MaxMaeder/SandTimer/casings/rev2/casings/Top.stl

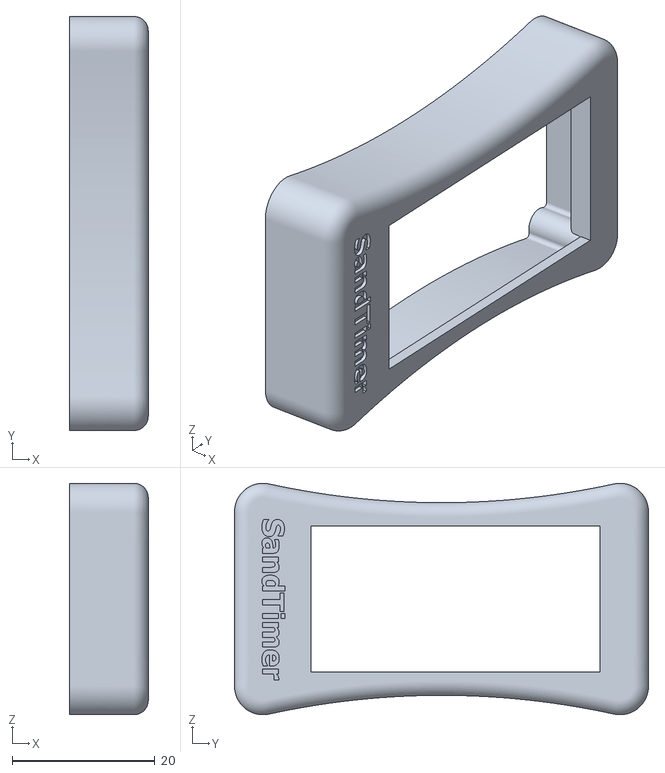
[picture p1: CAD file, 2024-05-12]
casings/rev2/casings/Top.stl
11.0 x 58.0 x 32.4
