MaxMaeder/SandTimer/casings/rev2/casings/Bottom.stl

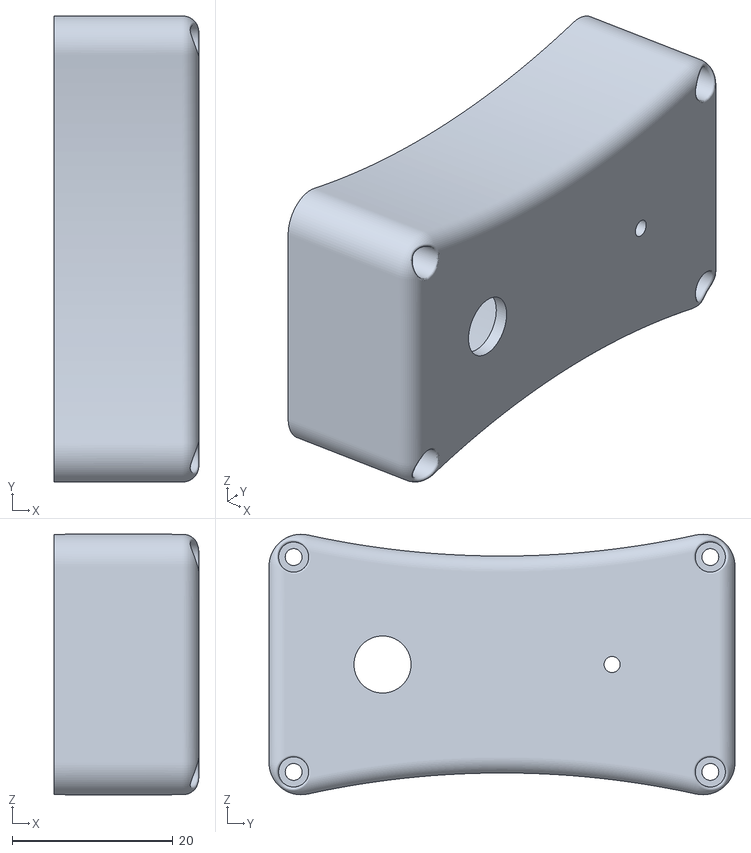
[picture p2: CAD file, 2024-05-12]
casings/rev2/casings/Bottom.stl
18.0 x 58.0 x 32.4
