MaxMaeder/SandTimer/casings/rev1/casings/FrontCasing.stl

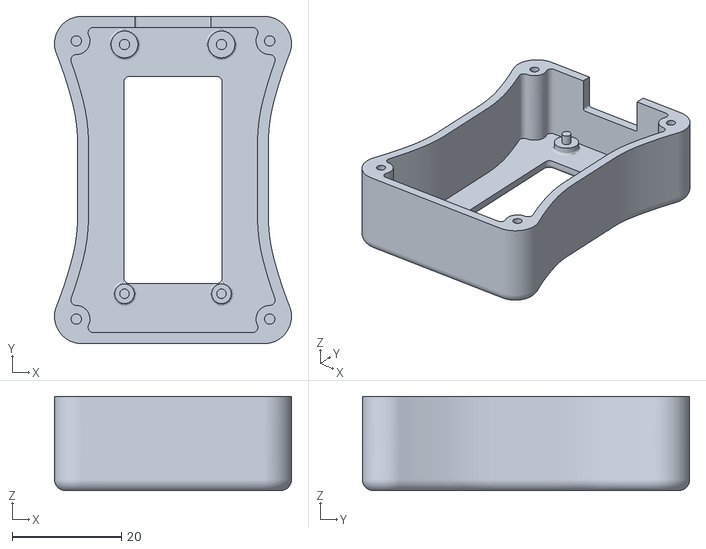
[picture p3: CAD file, 2024-05-12, an earlier design]
casings/rev1/casings/FrontCasing.stl
43.5 x 60.0 x 17.2
