MaxMaeder/SandTimer/casings/rev1/casings/BackCasing.stl

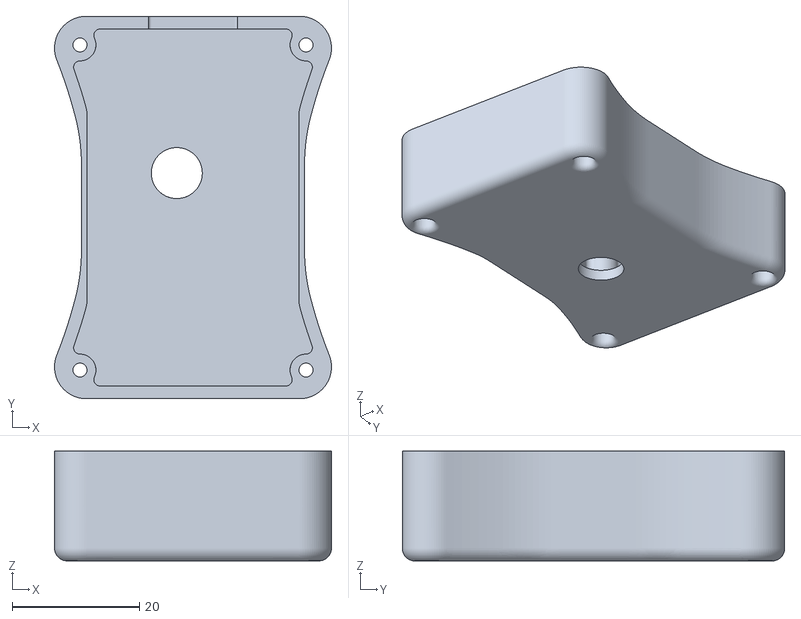
[picture p4: CAD file, 2024-05-12, an earlier design]
casings/rev1/casings/BackCasing.stl
43.5 x 60.0 x 17.2
