MaxMaeder/SandTimer/(list of files, cad)

Other CAD files:
casings/rev1/casings/BackCasing.ipt
casings/rev1/casings/Electronic Assembly.ipt
casings/rev1/casings/FrontCasing.ipt
casings/rev1/casings/OldVersions/BackCasing.0010.ipt
casings/rev1/casings/OldVersions/Electronic Assembly.0008.ipt
casings/rev1/casings/OldVersions/FrontCasing.0009.ipt
casings/rev1/casings/OldVersions/SandTimer.0003.iam
casings/rev1/casings/OldVersions/Stepper.0001.ipt
casings/rev1/casings/SandTimer.iam
casings/rev2/casings/12-Pin Header.ipt
casings/rev2/casings/16-Pin Header.ipt
casings/rev2/casings/Battery.ipt
casings/rev2/casings/Bottom.ipt
casings/rev2/casings/Controller Board.ipt
casings/rev2/casings/LED Board.ipt
casings/rev2/casings/OldVersions/12-Pin Header.0005.ipt
casings/rev2/casings/OldVersions/16-Pin Header.0004.ipt
casings/rev2/casings/OldVersions/Bottom.0027.ipt
casings/rev2/casings/OldVersions/Controller Board.0008.ipt
casings/rev2/casings/OldVersions/Controller Board.0009.ipt
casings/rev2/casings/OldVersions/LED Board.0007.ipt
casings/rev2/casings/OldVersions/Sand Timer.0019.iam
casings/rev2/casings/OldVersions/Top.0035.ipt
casings/rev2/casings/OldVersions/USB C Plug.0002.ipt
casings/rev2/casings/Sand Timer.iam
casings/rev2/casings/Top.ipt
casings/rev2/casings/USB C Plug.ipt
casings/rev2/casings/v1 - Bottom.ipt
casings/rev2/casings/v1 - Top.ipt
casings/rev2/casings/v1.1 - Bottom.ipt
casings/rev2/casings/v1.1 - Top.ipt
