MaxMaeder/SandTimer/boards/TimerControl.brd

## EAGLE design boards/TimerControl.brd (2024-01-23)

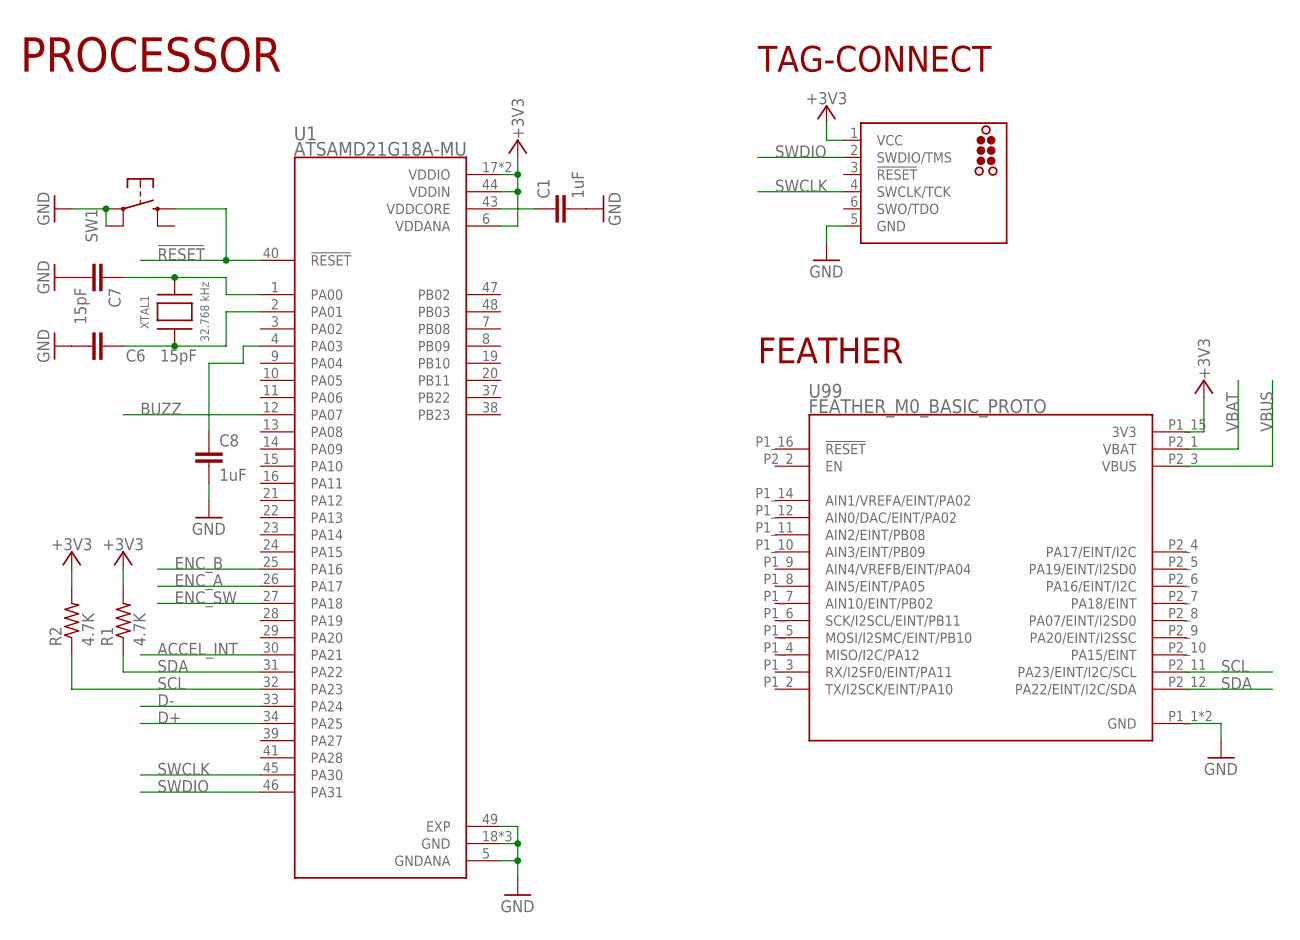
[picture p5: schematic TimerControl.sch, sheet 1]

Parts:
C1, C8: 1uF; C0603
C6, C7: 15pF; C0603
J3: TC2030_SWD-MCP-NL; TC2030-MCP-NL
R1, R2: 4.7K; R0603
SW1: KMR2; 2.80X4.60
U1: ATSAMD21G18A-MU; QFN50P700X700X90-49N
U99: FEATHER_M0_BASIC_PROTO; MODULE_FEATHER_M0_BASIC_PROTO
XTAL1: 32.768 kHz; XTAL3215

Connections:
!RESET: SW1.B (S), U1.40 (!RESET)
+3V3: J3.1 (VCC), R1.2, R2.2, U1.6 (VDDANA), U1.17 (VDDIO), U1.36 (VDDIO), U1.44 (VDDIN), U99.P1_15 (3V3); also elsewhere on the board
ACCEL_INT: U1.30 (PA21); also elsewhere on the board
BUZZ: U1.12 (PA07); also elsewhere on the board
D+: U1.34 (PA25); also elsewhere on the board
D-: U1.33 (PA24); also elsewhere on the board
ENC_A: U1.26 (PA17); also elsewhere on the board
ENC_B: U1.25 (PA16); also elsewhere on the board
ENC_SW: U1.27 (PA18); also elsewhere on the board
GND: C1.2, C6.2, C7.2, C8.2, J3.5 (GND), SW1.A, SW1.A' (P1), U1.5 (GNDANA), U1.18 (GND), U1.35 (GND), U1.42 (GND), U1.49 (EXP), U99.P1_1 (GND), U99.P1_13 (GND); also elsewhere on the board
unnamed: C1.1, U1.43 (VDDCORE)
unnamed: C8.1, U1.4 (PA03)
unnamed: C6.1, U1.2 (PA01), XTAL1.P$1
unnamed: C7.1, U1.1 (PA00), XTAL1.P$2
SCL: R2.1, U1.32 (PA23), U99.P2_11 (PA23/EINT/I2C/SCL); also elsewhere on the board
SDA: R1.1, U1.31 (PA22), U99.P2_12 (PA22/EINT/I2C/SDA); also elsewhere on the board
SWCLK: J3.4 (SWCLK/TCK), U1.45 (PA30)
SWDIO: J3.2 (SWDIO/TMS), U1.46 (PA31)
VBAT: U99.P2_1 (VBAT); also elsewhere on the board
VBUS: U99.P2_3 (VBUS); also elsewhere on the board

Notes on the sheet:
TAG-CONNECT
PROCESSOR
FEATHER

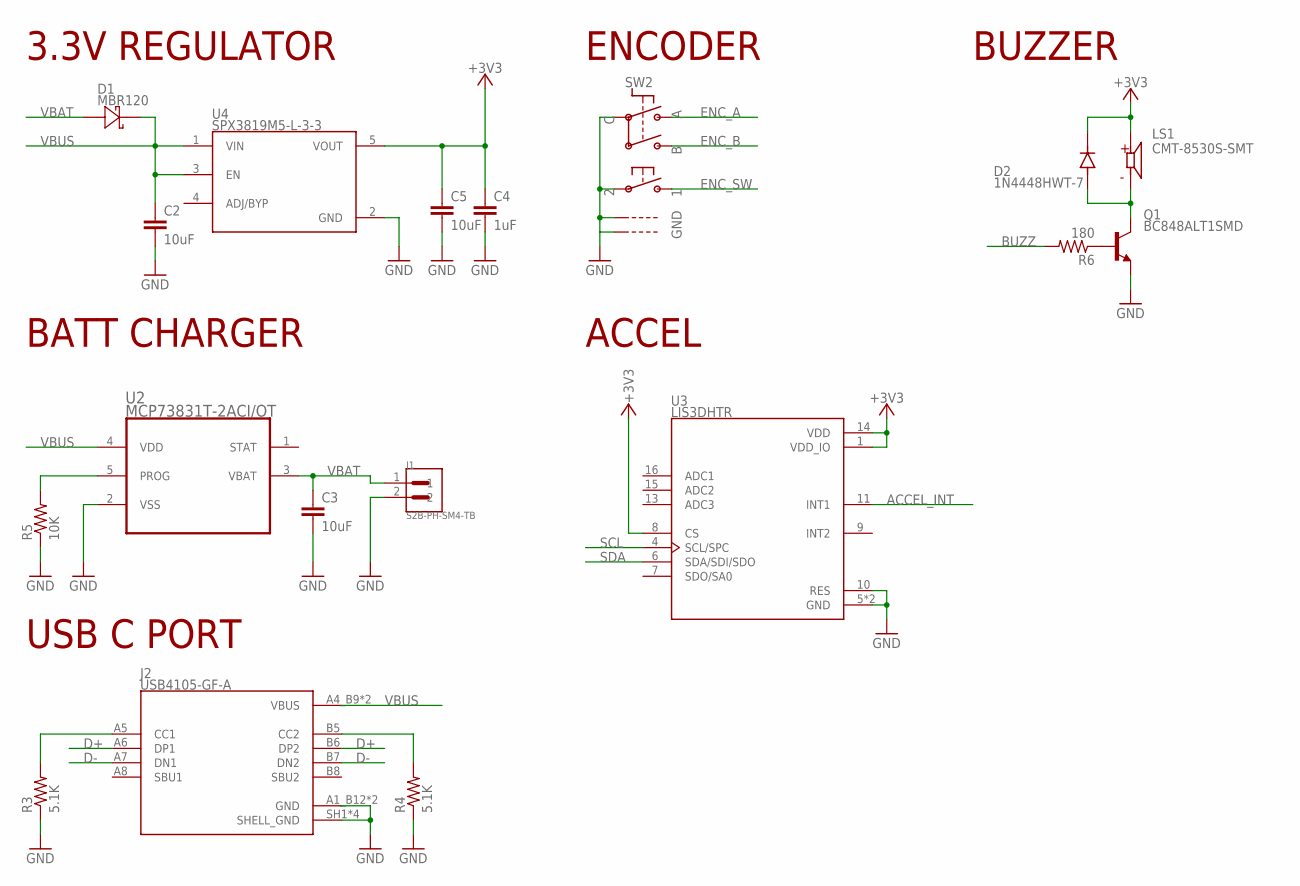
[picture p6: schematic TimerControl.sch, sheet 2]

Parts:
C2, C3, C5: 10uF; C0603
C4: 1uF; C0603
D1: MBR120; SOD−123FL
D2: 1N4448HWT-7; SODFL1608X65N
J1: S2B-PH-SM4-TB; JST_S2B-PH-SM4-TB
J2: USB4105-GF-A; GCT_USB4105-GF-A
LS1: CMT-8530S-SMT; CUI_CMT-8530S-SMT
Q1: BC848ALT1SMD; SOT23
R3, R4: 5.1K; R0603
R5: 10K; R0603
R6: 180; R0603
SW2: PEC11R_BOURNS_PEC11; PEC11R
U2: MCP73831T-2ACI/OT; SOT95P280X145-5N
U3: LIS3DHTR; XDCR_LIS3DHTR
U4: SPX3819M5-L-3-3; SOT95P280X145-5N

Connections:
+3V3: C4.1, C5.1, D2.C (K), LS1.P, U3.1 (VDD_IO), U3.8 (CS), U3.14 (VDD), U4.5 (VOUT); also elsewhere on the board
ACCEL_INT: U3.11 (INT1); also elsewhere on the board
BUZZ: R6.2; also elsewhere on the board
D+: J2.A6 (DP1), J2.B6 (DP2); also elsewhere on the board
D-: J2.A7 (DN1), J2.B7 (DN2); also elsewhere on the board
ENC_A: SW2.P$A; also elsewhere on the board
ENC_B: SW2.P$B; also elsewhere on the board
ENC_SW: SW2.P$1; also elsewhere on the board
GND: C2.2, C3.2, C4.2, C5.2, J1.2, J2.A1_B12 (GND), J2.B1_A12 (GND), J2.SH1 (SHELL_GND), J2.SH2 (SHELL_GND), J2.SH3 (SHELL_GND), J2.SH4 (SHELL_GND), Q1.2 (E), R3.1, R4.1, R5.1, SW2.P$2, SW2.P$C, SW2.P$GND1, SW2.P$GND2, U2.2 (VSS), U3.5 (GND), U3.10 (RES), U3.12 (GND), U4.2 (GND); also elsewhere on the board
unnamed: R5.2, U2.5 (PROG)
unnamed: J2.B5 (CC2), R4.2
unnamed: D2.A, LS1.N, Q1.3 (C)
unnamed: Q1.1 (B), R6.1
unnamed: J2.A5 (CC1), R3.2
SCL: U3.4 (SCL/SPC); also elsewhere on the board
SDA: U3.6 (SDA/SDI/SDO); also elsewhere on the board
VBAT: C3.1, D1.A (2), J1.1, U2.3 (VBAT); also elsewhere on the board
VBUS: C2.1, D1.C (1), J2.A4_B9 (VBUS), J2.B4_A9 (VBUS), U2.4 (VDD), U4.1 (VIN), U4.3 (EN); also elsewhere on the board

Notes on the sheet:
3.3V REGULATOR
BATT CHARGER
USB C PORT
ENCODER
ACCEL
BUZZER

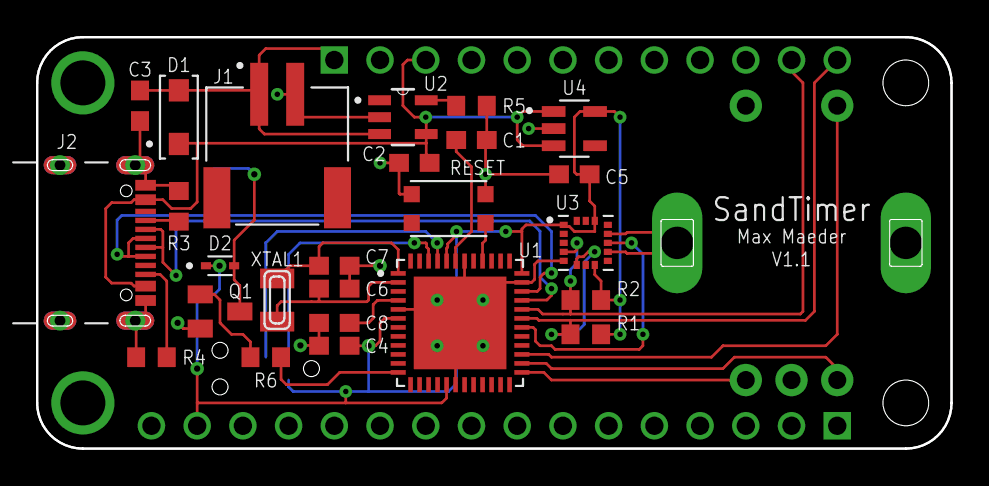
[picture p7: board TimerControl.brd from above]

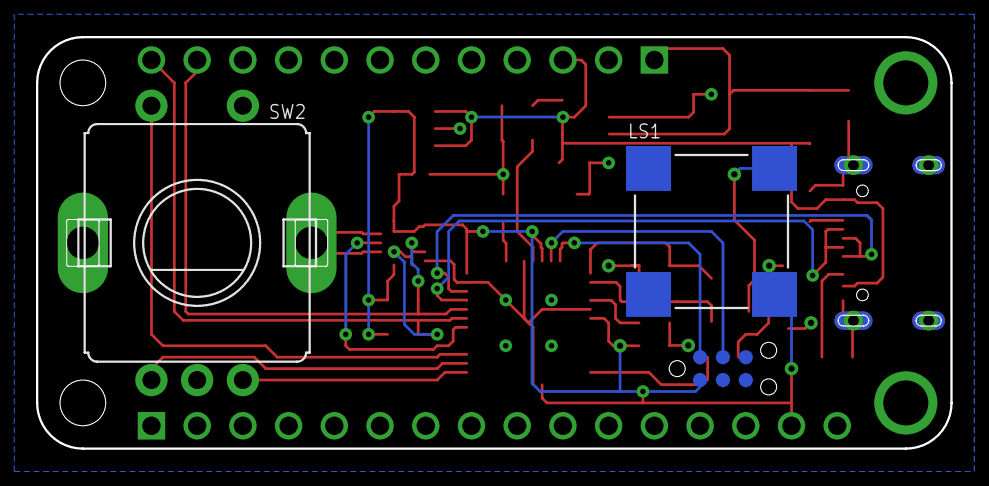
[picture p8: board TimerControl.brd from below]

Board: 2 copper layers, 50.8 x 22.9 mm, 29 parts (3 on the bottom side), 25 nets.
