MaxMaeder/SandTimer/(notices)

Notices in the files:
parts and their libraries:
Tag-Connect: ©2009 ROFA.cz - modified and updated by Robert Darlington ‹rdarlington@gmail.com›
